Rr42/USB-C-DB/Hardware/README.txt

# Read me for the USB-C display board hardware
This is a mini display board with a USB Type-C connector (carrying USB 2.0) and an onboard micro-controller.

This project is created using KiCAD (v5.1.10).

The goal of this display board is to test and evaluate:
* The USB-C interface for a Micro-controller
    * This design uses ESP-WROOM-02
* (TENTATIVE) Implementation of an onboard battery to power the board when disconnected from power
* (TENTATIVE) Onboard battery charging capability using USB-C

## License
The Software and firmware of this project is licensed under the the MIT license however the hardware is under the [Open Source Hardware](https://www.oshwa.org/definition/) license.
