Rr42/USB-C-DB/(list of files, cad)

Other CAD files:
Mechanical/case/case.blend
