Rr42/USB-C-DB/Hardware/support-sims/PWM/PWM-gen.asc

C1: cap; 47p
C2: cap; 47p
C3: cap; 47p
C4: cap; 47p
C5: cap; 47p
D1: diode; 1N4148
D2: diode; 1N4148
R1: res; 10k
R2: res; 10k
RPOT1: res; 500k
RPOT2: res; 500k
U1: NE555
V1: voltage; 5
Named nets: 0, VCC, PWM_OUT, TGR
1MEG
50% - 500K, 500k
70% - 700k, 300k
10% - 100k, 900k
.tran 1m
