Rr42/USB-C-DB/Hardware/support-sims/Auto-program/auto-program.asc

C1: cap; 0.1µ
C2: cap; 0.1µ
R1: res; 10k
R2: res; 10k
U1: 2N7002
U2: 2N7002
V1: voltage; 3.3
V2: voltage; PWL(0 0 100u 0 101u 3.3 200u 3.3 201u 3.3 300u 3.3 301u 0 400u 0)
V3: voltage; PWL(0 0 100u 0 101u 3.3 200u 3.3 201u 0 300u 0 301u 3.3 400u 3.3)
Named nets: 0, VCC, MCU_EN, MCU_IO0, UART_DTRN, UART_RTSN
.tran 400u
DTR RTS  EN IO0
 0     0      1   1
 1     1      1   1
 1     0      0   1
 0     1      1   0
