Rr42/USB-C-DB/Hardware/support-sims/Current-sns-amp/current-sns-amp.asc

R1: res; 5.1k
R2: res; 10k
R3: res; 1
R4: res; 22.73
R5: res; 5.1k
R6: res; 10k
U4: MAX4352
V1: voltage; PWL(0 0 1m 5)
V2: voltage; 5
V3: voltage; PWL(0 0 1m 220u)
Named nets: 0, +5V, Vinp, Vout, Vinn
Vout = (Vinp-Vinn) (R2/R1)
.tran 0 1.1m
PULSE(0 5 12.5u 100n 100n 12.5u 25u 100)
PULSE(0 5 250u 100n 100n 250u 500u 100)
PWL(0 0 9m 5)
120mA load
