Rr42/USB-C-DB/Hardware/support-sims/Switcher-ripple/switcher-ripple.asc

C1: cap; 0.1µ
C2: cap; 1µ
I1: current; PULSE(0 220m 12.5u 150n 100n 12.5u 25u 100)
L1: ind; 3µ; Ipk=1 Rser=88m Rpar=750 Cpar=500f
L2: ind; 3µ; Ipk=1 Rser=88m Rpar=750 Cpar=500f
M1: nmos; BSZ0904NSI
M2: nmos; BSZ0904NSI
R1: res; 22.73
R2: res; 15
R3: res; 22.73
V1: voltage; PULSE(0 5 12.5u 100n 100n 12.5u 25u 100)
V2: voltage; 5
V3: voltage; PULSE(0 5 12.5u 100n 100n 12.5u 25u 100)
Named nets: 0, Vload, Vsrc, Vpwm
.tran 1m
3.3V
5V
