Rr42/USB-C-DB/Hardware/USB-C-DB/USB-C-DB.kicad_pcb

## KiCad design Hardware/USB-C-DB/USB-C-DB.kicad_pcb (2023-08-28)

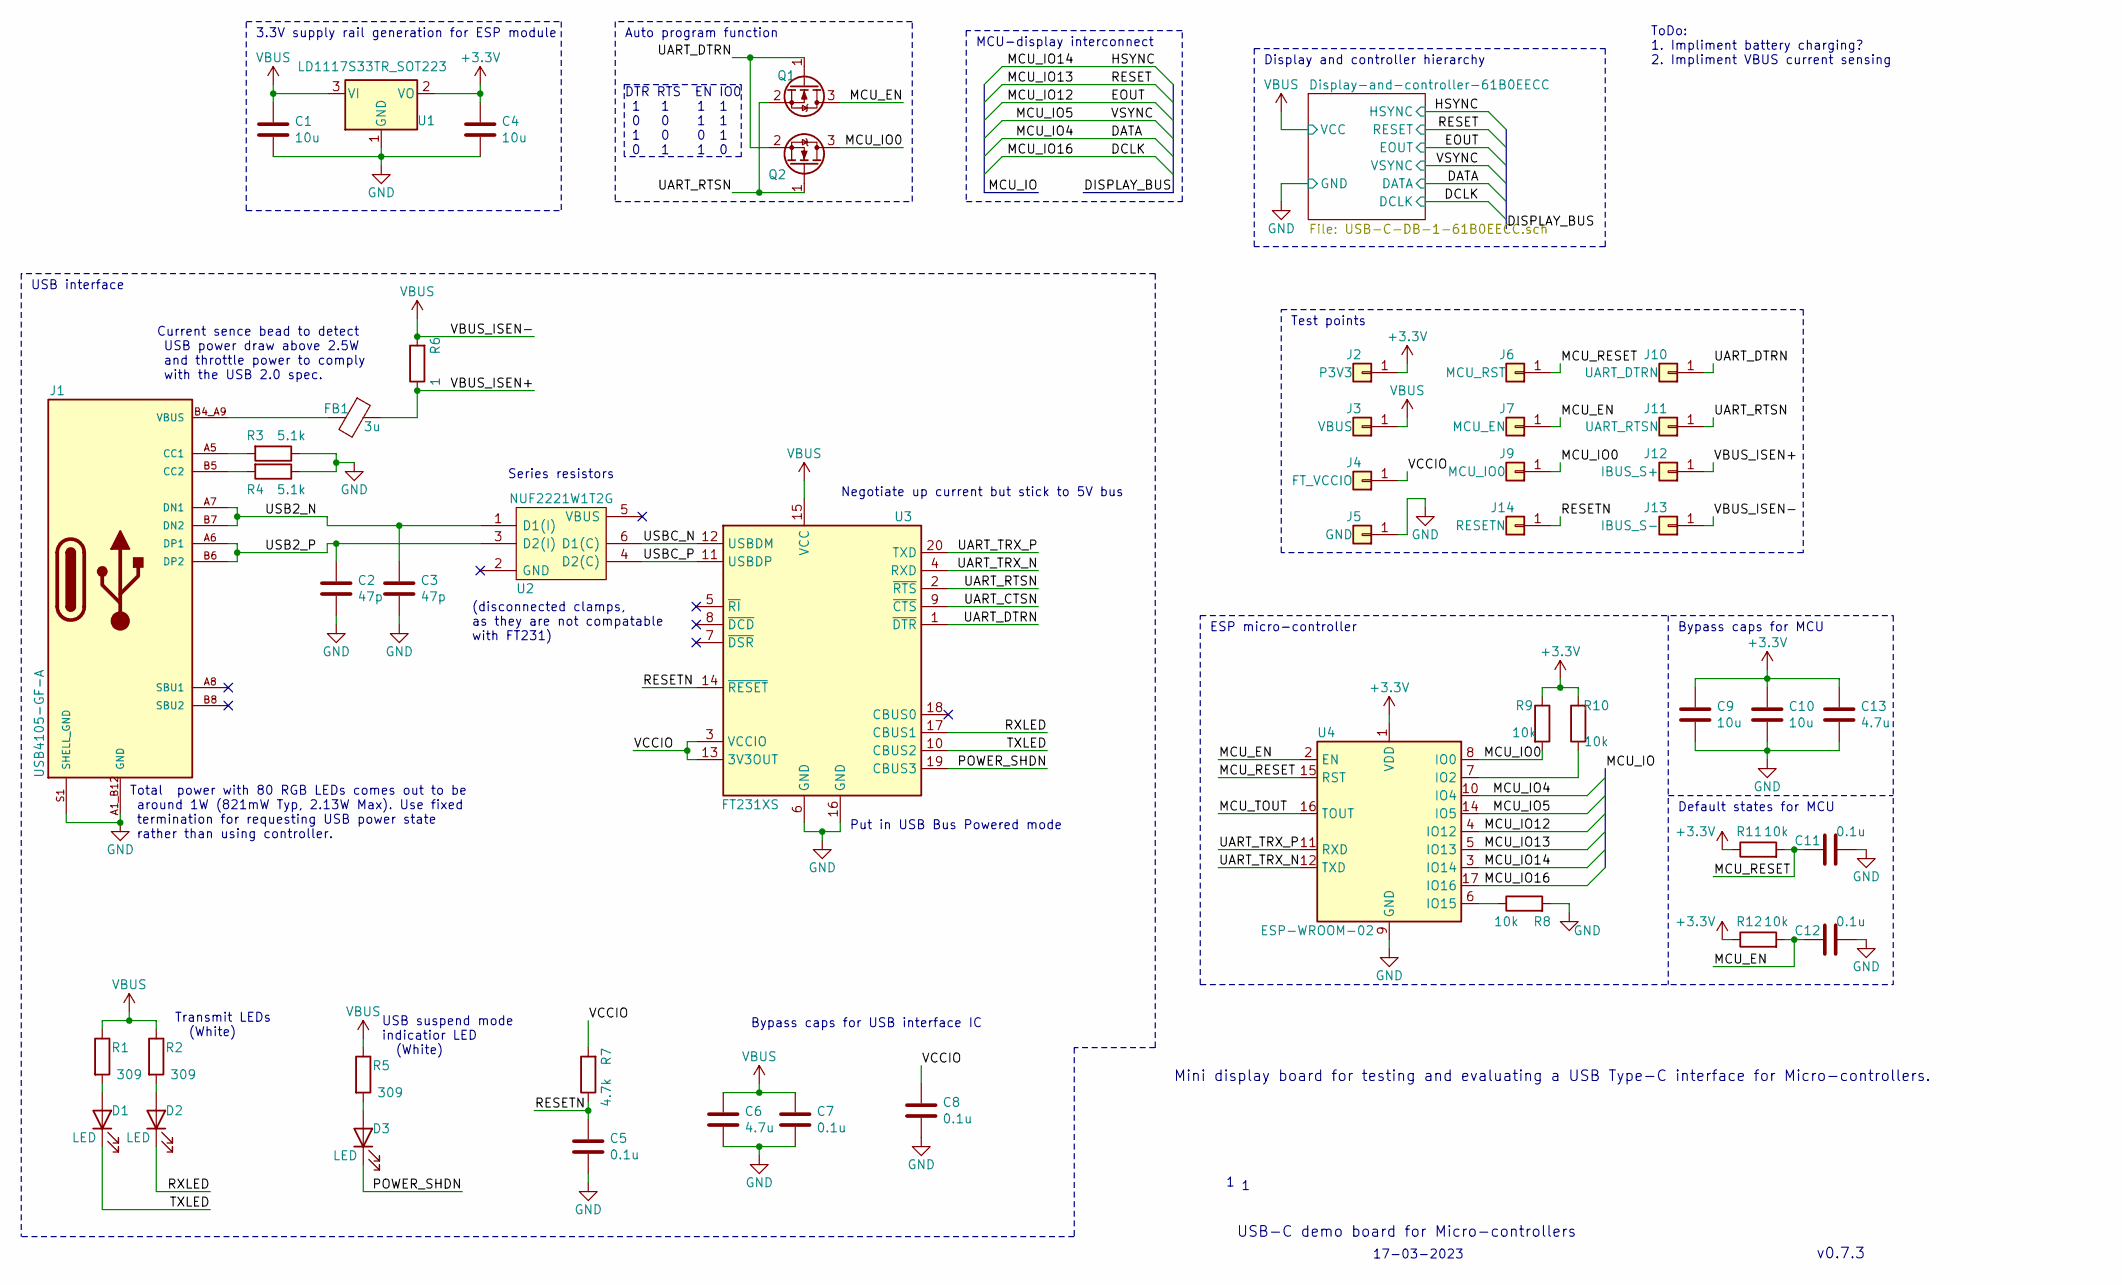
[picture p14: schematic USB-C-DB.sch]

Parts:
C1, C4, C9, C10: 10u; C_0805_2012Metric_Pad1.18x1.45mm_HandSolder; MPN CL21A106KOQNNNE
C2, C3: 47p; C_0402_1005Metric_Pad0.74x0.62mm_HandSolder; MPN C0402C470J5GAC
C5, C7, C8, C11, C12: 0.1u; C_0805_2012Metric_Pad1.18x1.45mm_HandSolder; MPN C0805C104M5RAC
C6, C13: 4.7u; C_0805_2012Metric_Pad1.18x1.45mm_HandSolder; MPN CL21A475KAQNNNF
D1, D2, D3: LED; LED_Cree-PLCC4_3.2x2.8mm_CCW; MPN CLA1A-WKB-CWbYa153
FB1: 3u; R_0603_1608Metric_Pad0.98x0.95mm_HandSolder; MPN KPZ1608SHR601ATD25
J1: USB4105-GF-A; GCT_USB4105-GF-A; PARTREV A3
J2: P3V3; TestPoint_Pad_D1.0mm
J3: VBUS; TestPoint_Pad_D1.0mm
J4: FT_VCCIO; TestPoint_Pad_D1.0mm
J5: GND; TestPoint_Pad_D1.0mm
J6: MCU_RST; TestPoint_Pad_D1.0mm
J7: MCU_EN; TestPoint_Pad_D1.0mm
J9: MCU_IO0; TestPoint_Pad_D1.0mm
J10: UART_DTRN; TestPoint_Pad_D1.0mm
J11: UART_RTSN; TestPoint_Pad_D1.0mm
J12: IBUS_S+; TestPoint_Pad_D1.0mm
J13: IBUS_S-; TestPoint_Pad_D1.0mm
J14: RESETN; TestPoint_Pad_D1.0mm
Q1, Q2: XP262N7002TR-G; SOT-23; MPN XP262N7002TR-G
R1, R2, R5: 309; R_0603_1608Metric_Pad0.98x0.95mm_HandSolder; MPN RC0603FR-07309RL
R3, R4: 5.1k; R_0805_2012Metric_Pad1.20x1.40mm_HandSolder; MPN TR0805KR-075K1L
R6: 1; R_0603_1608Metric_Pad0.98x0.95mm_HandSolder; MPN RT0603DRE071RL
R7: 4.7k; R_0805_2012Metric_Pad1.20x1.40mm_HandSolder; MPN RC0805FR-074K7P
R8, R9, R10, R11, R12: 10k; R_0603_1608Metric_Pad0.98x0.95mm_HandSolder; MPN CRG0603F10K/10
U1: LD1117S33TR_SOT223; SOT-223-3_TabPin2; MPN LD1117S33CTR
U2: NUF2221W1T2G; SOT65P210X110-6N; Mouser Part Number 863-NUF2221W1T2G
U3: FT231XS; SSOP-20_3.9x8.7mm_P0.635mm; MPN FT231XS-R; Mouser Part Number 895-FT231XS-R
U4: ESP-WROOM-02; MPN ESP-WROOM-02D-N2

Connections:
+3V3: C4.1, C9.1, C10.1, C13.1, J2.1, R9.1, R10.2, R11.1, R12.1, U1.2 (VO), U4.1 (VDD)
/DATA: U4.10 (IO4); also elsewhere on the board
/DCLK: U4.17 (IO16); also elsewhere on the board
/EOUT: U4.4 (IO12); also elsewhere on the board
/HSYNC: U4.3 (IO14); also elsewhere on the board
/MCU_EN: C12.1, J7.1, Q1.3 (D), R12.2, U4.2 (EN)
/MCU_IO0: J9.1, Q2.3 (D), R9.2, U4.8 (IO0)
/MCU_IO5: U4.14 (IO5); also elsewhere on the board
/MCU_IO13: U4.5 (IO13); also elsewhere on the board
/MCU_RESET: C11.1, J6.1, R11.2, U4.15 (RST)
/MCU_TOUT: U4.16 (TOUT)
/POWER_SHDN: D3.4 (K), U3.19 (CBUS3)
/RESETN: C5.1, J14.1, R7.1, U3.14 (~RESET)
/RXLED: D2.4 (K), U3.17 (CBUS1)
/TXLED: D1.4 (K), U3.10 (CBUS2)
/UART_CTSN: U3.9 (~CTS)
/UART_DTRN: J10.1, Q1.1 (G), Q2.2 (S), U3.1 (~DTR)
/UART_RTSN: J11.1, Q1.2 (S), Q2.1 (G), U3.2 (~RTS)
/UART_TRX_N: U3.4 (RXD), U4.12 (TXD)
/UART_TRX_P: U3.20 (TXD), U4.11 (RXD)
/USB2_N: C3.1, J1.A7 (DN1), J1.B7 (DN2), U2.1 (D1(I))
/USB2_P: C2.1, J1.A6 (DP1), J1.B6 (DP2), U2.3 (D2(I))
/USBC_N: U2.6 (D1(C)), U3.12 (USBDM)
/USBC_P: U2.4 (D2(C)), U3.11 (USBDP)
/VBUS_ISEN+: FB1.1, J12.1, R6.1
/VCCIO: C8.1, J4.1, R7.2, U3.3 (VCCIO), U3.13 (3V3OUT)
GND: C1.2, C2.2, C3.2, C4.2, C5.2, C6.2, C7.2, C8.2, C9.2, C10.2, C11.2, C12.2, C13.2, J1.A1_B12 (GND), J1.B1_A12 (GND), J1.S1 (SHELL_GND), J1.S2 (SHELL_GND), J1.S3 (SHELL_GND), J1.S4 (SHELL_GND), J5.1, R3.1, R4.1, R8.2, U1.1 (GND), U3.6 (GND), U3.16 (GND), U4.9 (GND), U4.13 (GND), U4.18 (GND), U4.19 (GND); also elsewhere on the board
unnamed: D1.2 (A), R1.2
unnamed: D2.2 (A), R2.2
unnamed: D3.2 (A), R5.2
unnamed: J1.A5 (CC1), R3.2
unnamed: J1.B5 (CC2), R4.2
unnamed: R8.1, U4.6 (IO15)
unnamed: R10.1, U4.7 (IO2)

Notes on the sheet:
USB-C demo board for Micro-controllers
v0.7.3
17-03-2023
Mini display board for testing and evaluating a USB Type-C interface for Micro-controllers.
Total power with 80 RGB LEDs comes out to be around 1W (821mW Typ, 2.13W Max). Use fixed termination for requesting USB power state rather than using controller.
Current sence bead to detect USB power draw above 2.5W and throttle power to comply with the USB 2.0 spec.
Display and controller hierarchy
Series resistors
Bypass caps for USB interface IC
USB interface
Auto program function
DTR RTS EN IO0 1 1 1 1 0 0 1 1 1 0 0 1 0 1 1 0
MCU-display interconnect
3.3V supply rail generation for ESP module
Test points
Default states for MCU
ESP micro-controller
Bypass caps for MCU
ToDo: 1. Impliment battery charging? 2. Impliment VBUS current sensing
Negotiate up current but stick to 5V bus
Put in USB Bus Powered mode
Transmit LEDs (White)
USB suspend mode indicatior LED (White)
(disconnected clamps, as they are not compatable with FT231)

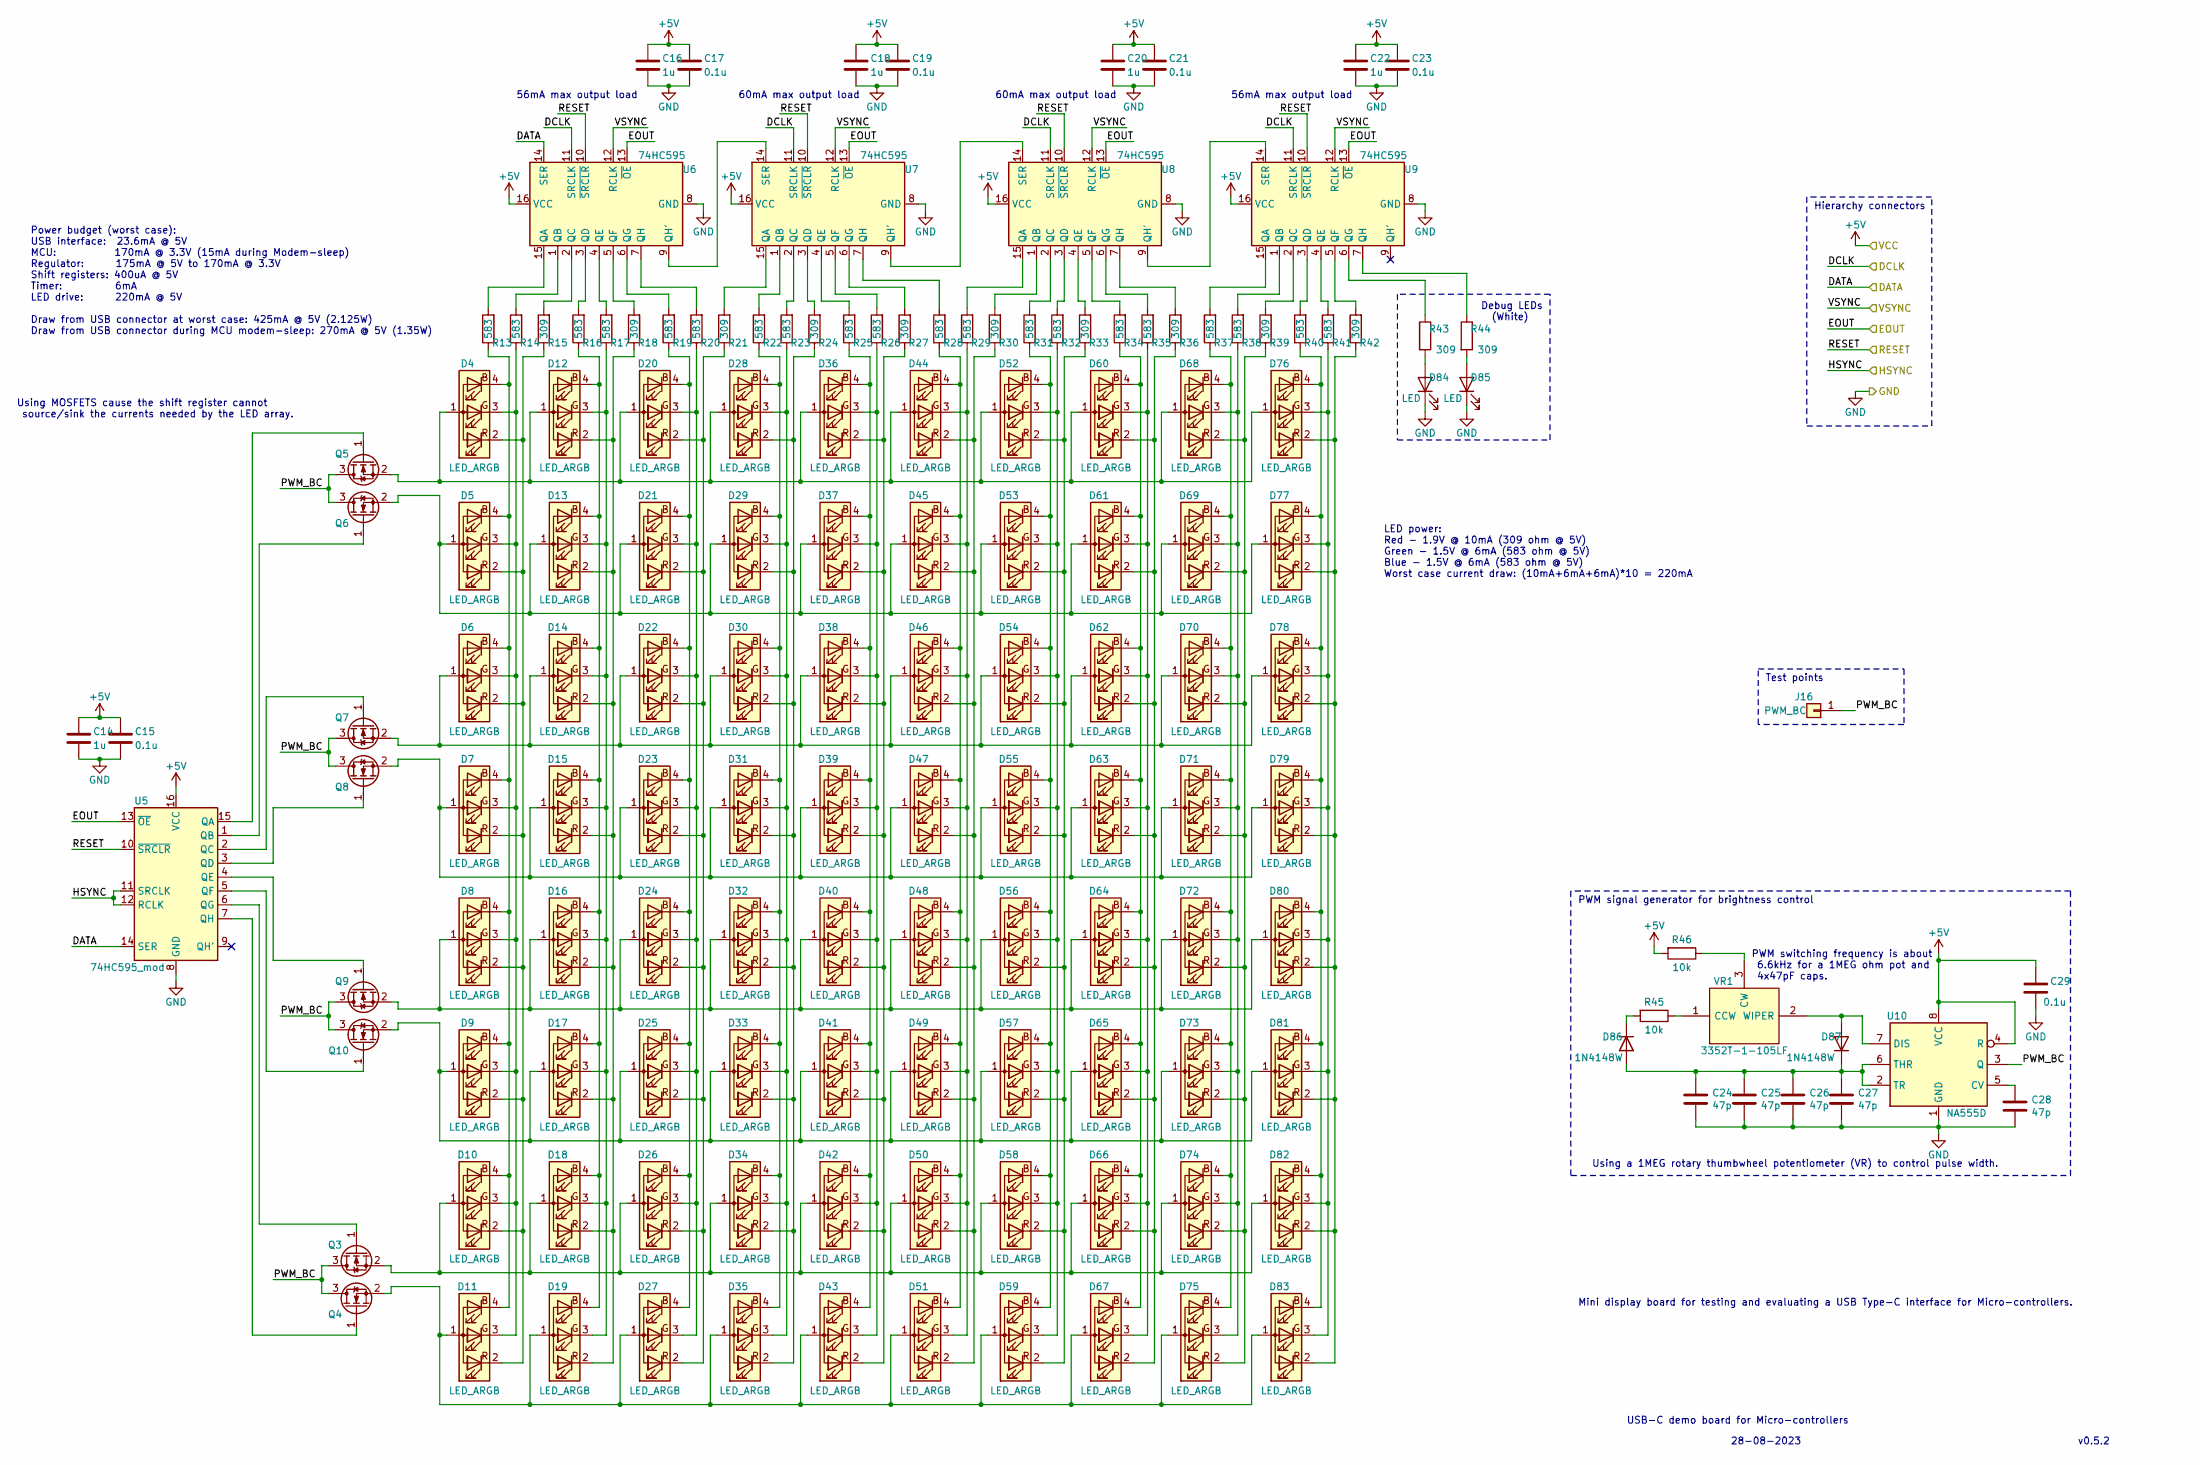
[picture p15: schematic USB-C-DB-1-61B0EECC.sch]

Parts:
C14, C16, C18, C20, C22: 1u; C_0805_2012Metric_Pad1.18x1.45mm_HandSolder; MPN CL21B105KBFNNNG
C15, C17, C19, C21, C23, C29: 0.1u; C_0805_2012Metric_Pad1.18x1.45mm_HandSolder; MPN C0805C104M5RAC
C24, C25, C26, C27, C28: 47p; C_0402_1005Metric_Pad0.74x0.62mm_HandSolder; MPN C0402C470J5GAC
D4, D5, D6, D7, D8, D9, D10, D11, D12, D13, D14, D15, D16, D17, D18, D19, D20, D21, D22, D23, D24, D25, D26, D27, D28, D29, D30, D31, D32, D33, D34, D35, D36, D37, D38, D39, D40, D41, D42, D43, D44, D45, D46, D47, D48, D49, D50, D51, D52, D53, D54, D55, D56, D57, D58, D59, D60, D61, D62, D63, D64, D65, D66, D67, D68, D69, D70, D71, D72, D73, D74, D75, D76, D77, D78, D79, D80, D81, D82, D83: LED_ARGB; LED_Cree-PLCC4_3.2x2.8mm_CCW; MPN CLV1L-FKB-CJ1N1E1BB7B3B3
D84, D85: LED; LED_Cree-PLCC4_3.2x2.8mm_CCW; MPN CLA1A-WKB-CWbYa153
D86, D87: 1N4148W; D_SOD-123; MPN 1N4148W_R1_00001
J16: PWM_BC; TestPoint_Pad_D1.0mm
Q3, Q4, Q5, Q6, Q7, Q8, Q9, Q10: XP262N7002TR-G; SOT-23; MPN XP262N7002TR-G
R13, R14, R16, R17, R19, R20, R22, R23, R25, R26, R28, R29, R31, R32, R34, R35, R37, R38, R40, R41: 583; R_0603_1608Metric_Pad0.98x0.95mm_HandSolder; MPN RT0603DRE07583RL
R15, R18, R21, R24, R27, R30, R33, R36, R39, R42, R43, R44: 309; R_0603_1608Metric_Pad0.98x0.95mm_HandSolder; MPN RC0603FR-07309RL
R45, R46: 10k; R_0603_1608Metric_Pad0.98x0.95mm_HandSolder; MPN CRG0603F10K/10
U5: 74HC595_mod; TSSOP-16_4.4x5mm_P0.65mm; MPN MC74HC595ADTG
U6, U7, U8, U9: 74HC595; TSSOP-16_4.4x5mm_P0.65mm; MPN MC74HC595ADTG
U10: NA555D; SOIC-8_3.9x4.9mm_P1.27mm; MPN NA555DR
VR1: 3352T-1-105LF; 3352T1103LF; Mouser Part Number 652-3352T-1-105LF

Connections:
/DATA: U5.14 (SER), U6.14 (SER); also elsewhere on the board
/DCLK: U6.11 (SRCLK), U7.11 (SRCLK), U8.11 (SRCLK), U9.11 (SRCLK); also elsewhere on the board
/Display-and-controller-61B0EECC/PWM_BC: J16.1, Q3.3 (D), Q4.3 (D), Q5.3 (D), Q6.3 (D), Q7.3 (D), Q8.3 (D), Q9.3 (D), Q10.3 (D), U10.3 (Q)
/EOUT: U5.13 (~OE), U6.13 (~OE), U7.13 (~OE), U8.13 (~OE), U9.13 (~OE); also elsewhere on the board
/HSYNC: U5.11 (SRCLK), U5.12 (RCLK); also elsewhere on the board
/MCU_IO5: U6.12 (RCLK), U7.12 (RCLK), U8.12 (RCLK), U9.12 (RCLK); also elsewhere on the board
/MCU_IO13: U5.10 (~SRCLR), U6.10 (~SRCLR), U7.10 (~SRCLR), U8.10 (~SRCLR), U9.10 (~SRCLR); also elsewhere on the board
GND: C14.2, C15.2, C16.2, C17.2, C18.2, C19.2, C20.2, C21.2, C22.2, C23.2, C24.2, C25.2, C26.2, C27.2, C28.2, C29.2, D84.4 (K), D85.4 (K), U5.8 (GND), U6.8 (GND), U7.8 (GND), U8.8 (GND), U9.8 (GND), U10.1 (GND); also elsewhere on the board
unnamed: C24.1, C25.1, C26.1, C27.1, D86.2 (A), D87.1 (K), U10.2 (TR), U10.6 (THR)
unnamed: C28.1, U10.5 (CV)
unnamed: D10.1 (A), D18.1 (A), D26.1 (A), D34.1 (A), D42.1 (A), D50.1 (A), D58.1 (A), D66.1 (A), D74.1 (A), D82.1 (A), Q3.2 (S)
unnamed: D4.2 (RK), D5.2 (RK), D6.2 (RK), D7.2 (RK), D8.2 (RK), D9.2 (RK), D10.2 (RK), D11.2 (RK), R15.1
unnamed: D4.3 (GK), D5.3 (GK), D6.3 (GK), D7.3 (GK), D8.3 (GK), D9.3 (GK), D10.3 (GK), D11.3 (GK), R14.1
unnamed: D4.4 (BK), D5.4 (BK), D6.4 (BK), D7.4 (BK), D8.4 (BK), D9.4 (BK), D10.4 (BK), D11.4 (BK), R13.1
unnamed: D11.1 (A), D19.1 (A), D27.1 (A), D35.1 (A), D43.1 (A), D51.1 (A), D59.1 (A), D67.1 (A), D75.1 (A), D83.1 (A), Q4.2 (S)
unnamed: D4.1 (A), D12.1 (A), D20.1 (A), D28.1 (A), D36.1 (A), D44.1 (A), D52.1 (A), D60.1 (A), D68.1 (A), D76.1 (A), Q5.2 (S)
unnamed: D12.2 (RK), D13.2 (RK), D14.2 (RK), D15.2 (RK), D16.2 (RK), D17.2 (RK), D18.2 (RK), D19.2 (RK), R18.1
unnamed: D12.3 (GK), D13.3 (GK), D14.3 (GK), D15.3 (GK), D16.3 (GK), D17.3 (GK), D18.3 (GK), D19.3 (GK), R17.1
unnamed: D12.4 (BK), D13.4 (BK), D14.4 (BK), D15.4 (BK), D16.4 (BK), D17.4 (BK), D18.4 (BK), D19.4 (BK), R16.1
unnamed: D5.1 (A), D13.1 (A), D21.1 (A), D29.1 (A), D37.1 (A), D45.1 (A), D53.1 (A), D61.1 (A), D69.1 (A), D77.1 (A), Q6.2 (S)
unnamed: D6.1 (A), D14.1 (A), D22.1 (A), D30.1 (A), D38.1 (A), D46.1 (A), D54.1 (A), D62.1 (A), D70.1 (A), D78.1 (A), Q7.2 (S)
unnamed: D7.1 (A), D15.1 (A), D23.1 (A), D31.1 (A), D39.1 (A), D47.1 (A), D55.1 (A), D63.1 (A), D71.1 (A), D79.1 (A), Q8.2 (S)
unnamed: D8.1 (A), D16.1 (A), D24.1 (A), D32.1 (A), D40.1 (A), D48.1 (A), D56.1 (A), D64.1 (A), D72.1 (A), D80.1 (A), Q9.2 (S)
unnamed: D9.1 (A), D17.1 (A), D25.1 (A), D33.1 (A), D41.1 (A), D49.1 (A), D57.1 (A), D65.1 (A), D73.1 (A), D81.1 (A), Q10.2 (S)
unnamed: D20.2 (RK), D21.2 (RK), D22.2 (RK), D23.2 (RK), D24.2 (RK), D25.2 (RK), D26.2 (RK), D27.2 (RK), R21.1
unnamed: D20.3 (GK), D21.3 (GK), D22.3 (GK), D23.3 (GK), D24.3 (GK), D25.3 (GK), D26.3 (GK), D27.3 (GK), R20.1
unnamed: D20.4 (BK), D21.4 (BK), D22.4 (BK), D23.4 (BK), D24.4 (BK), D25.4 (BK), D26.4 (BK), D27.4 (BK), R19.1
unnamed: D28.2 (RK), D29.2 (RK), D30.2 (RK), D31.2 (RK), D32.2 (RK), D33.2 (RK), D34.2 (RK), D35.2 (RK), R24.1
unnamed: D28.3 (GK), D29.3 (GK), D30.3 (GK), D31.3 (GK), D32.3 (GK), D33.3 (GK), D34.3 (GK), D35.3 (GK), R23.1
unnamed: D28.4 (BK), D29.4 (BK), D30.4 (BK), D31.4 (BK), D32.4 (BK), D33.4 (BK), D34.4 (BK), D35.4 (BK), R22.1
unnamed: D36.2 (RK), D37.2 (RK), D38.2 (RK), D39.2 (RK), D40.2 (RK), D41.2 (RK), D42.2 (RK), D43.2 (RK), R27.1
unnamed: D36.3 (GK), D37.3 (GK), D38.3 (GK), D39.3 (GK), D40.3 (GK), D41.3 (GK), D42.3 (GK), D43.3 (GK), R26.1
unnamed: D36.4 (BK), D37.4 (BK), D38.4 (BK), D39.4 (BK), D40.4 (BK), D41.4 (BK), D42.4 (BK), D43.4 (BK), R25.1
unnamed: D44.2 (RK), D45.2 (RK), D46.2 (RK), D47.2 (RK), D48.2 (RK), D49.2 (RK), D50.2 (RK), D51.2 (RK), R30.1
unnamed: D44.3 (GK), D45.3 (GK), D46.3 (GK), D47.3 (GK), D48.3 (GK), D49.3 (GK), D50.3 (GK), D51.3 (GK), R29.1
unnamed: D44.4 (BK), D45.4 (BK), D46.4 (BK), D47.4 (BK), D48.4 (BK), D49.4 (BK), D50.4 (BK), D51.4 (BK), R28.1
unnamed: D52.2 (RK), D53.2 (RK), D54.2 (RK), D55.2 (RK), D56.2 (RK), D57.2 (RK), D58.2 (RK), D59.2 (RK), R33.1
unnamed: D52.3 (GK), D53.3 (GK), D54.3 (GK), D55.3 (GK), D56.3 (GK), D57.3 (GK), D58.3 (GK), D59.3 (GK), R32.1
unnamed: D52.4 (BK), D53.4 (BK), D54.4 (BK), D55.4 (BK), D56.4 (BK), D57.4 (BK), D58.4 (BK), D59.4 (BK), R31.1
unnamed: D60.2 (RK), D61.2 (RK), D62.2 (RK), D63.2 (RK), D64.2 (RK), D65.2 (RK), D66.2 (RK), D67.2 (RK), R36.1
unnamed: D60.3 (GK), D61.3 (GK), D62.3 (GK), D63.3 (GK), D64.3 (GK), D65.3 (GK), D66.3 (GK), D67.3 (GK), R35.1
unnamed: D60.4 (BK), D61.4 (BK), D62.4 (BK), D63.4 (BK), D64.4 (BK), D65.4 (BK), D66.4 (BK), D67.4 (BK), R34.1
unnamed: D68.2 (RK), D69.2 (RK), D70.2 (RK), D71.2 (RK), D72.2 (RK), D73.2 (RK), D74.2 (RK), D75.2 (RK), R39.1
unnamed: D68.3 (GK), D69.3 (GK), D70.3 (GK), D71.3 (GK), D72.3 (GK), D73.3 (GK), D74.3 (GK), D75.3 (GK), R38.1
unnamed: D68.4 (BK), D69.4 (BK), D70.4 (BK), D71.4 (BK), D72.4 (BK), D73.4 (BK), D74.4 (BK), D75.4 (BK), R37.1
unnamed: D76.2 (RK), D77.2 (RK), D78.2 (RK), D79.2 (RK), D80.2 (RK), D81.2 (RK), D82.2 (RK), D83.2 (RK), R42.1
unnamed: D76.3 (GK), D77.3 (GK), D78.3 (GK), D79.3 (GK), D80.3 (GK), D81.3 (GK), D82.3 (GK), D83.3 (GK), R41.1
unnamed: D76.4 (BK), D77.4 (BK), D78.4 (BK), D79.4 (BK), D80.4 (BK), D81.4 (BK), D82.4 (BK), D83.4 (BK), R40.1
unnamed: D84.2 (A), R43.2
unnamed: D85.2 (A), R44.2
unnamed: D86.1 (K), R45.2
unnamed: D87.2 (A), U10.7 (DIS), VR1.2 (WIPER)
unnamed: Q3.1 (G), U5.6 (QG)
unnamed: Q4.1 (G), U5.7 (QH)
unnamed: Q5.1 (G), U5.15 (QA)
unnamed: Q6.1 (G), U5.1 (QB)
unnamed: Q7.1 (G), U5.2 (QC)
unnamed: Q8.1 (G), U5.3 (QD)
unnamed: Q9.1 (G), U5.4 (QE)
unnamed: Q10.1 (G), U5.5 (QF)
unnamed: R13.2, U6.15 (QA)
unnamed: R14.2, U6.1 (QB)
unnamed: R15.2, U6.2 (QC)
unnamed: R16.2, U6.3 (QD)
unnamed: R17.2, U6.4 (QE)
unnamed: R18.2, U6.5 (QF)
unnamed: R19.2, U6.6 (QG)
unnamed: R20.2, U6.7 (QH)
unnamed: R21.2, U7.15 (QA)
unnamed: R22.2, U7.1 (QB)
unnamed: R23.2, U7.2 (QC)
unnamed: R24.2, U7.3 (QD)
unnamed: R25.2, U7.4 (QE)
unnamed: R26.2, U7.5 (QF)
unnamed: R27.2, U7.6 (QG)
unnamed: R28.2, U7.7 (QH)
unnamed: R29.2, U8.15 (QA)
unnamed: R30.2, U8.1 (QB)
unnamed: R31.2, U8.2 (QC)
unnamed: R32.2, U8.3 (QD)
unnamed: R33.2, U8.4 (QE)
unnamed: R34.2, U8.5 (QF)
unnamed: R35.2, U8.6 (QG)
unnamed: R36.2, U8.7 (QH)
unnamed: R37.2, U9.15 (QA)
unnamed: R38.2, U9.1 (QB)
unnamed: R39.2, U9.2 (QC)
unnamed: R40.2, U9.3 (QD)
unnamed: R41.2, U9.4 (QE)
unnamed: R42.2, U9.5 (QF)
unnamed: R43.1, U9.6 (QG)
unnamed: R44.1, U9.7 (QH)
unnamed: R45.1, VR1.1 (CCW)
unnamed: R46.1, VR1.3 (CW)
unnamed: U6.9 (QH'), U7.14 (SER)
unnamed: U7.9 (QH'), U8.14 (SER)
unnamed: U8.9 (QH'), U9.14 (SER)

Notes on the sheet:
USB-C demo board for Micro-controllers
28-08-2023
v0.5.2
Debug LEDs (White)
LED power: Red - 1.9V @ 10mA (309 ohm @ 5V) Green - 1.5V @ 6mA (583 ohm @ 5V) Blue - 1.5V @ 6mA (583 ohm @ 5V) Worst case current draw: (10mA+6mA+6mA)*10 = 220mA
Mini display board for testing and evaluating a USB Type-C interface for Micro-controllers.
Hierarchy connectors
Power budget (worst case): USB interface: 23.6mA @ 5V MCU: 170mA @ 3.3V (15mA during Modem-sleep) Regulator: 175mA @ 5V to 170mA @ 3.3V Shift registers: 400uA @ 5V Timer: 6mA LED drive: 220mA @ 5V Draw from USB connector at worst case: 425mA @ 5V (2.125W) Draw from USB connector during MCU modem-sl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
Using MOSFETS cause the shift register cannot source/sink the currents needed by the LED array.
Using a 1MEG rotary thumbwheel potentiometer (VR) to control pulse width.
PWM switching frequency is about 6.6kHz for a 1MEG ohm pot and 4x47pF caps.
PWM signal generator for brightness control
Test points
60mA max output load
56mA max output load

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
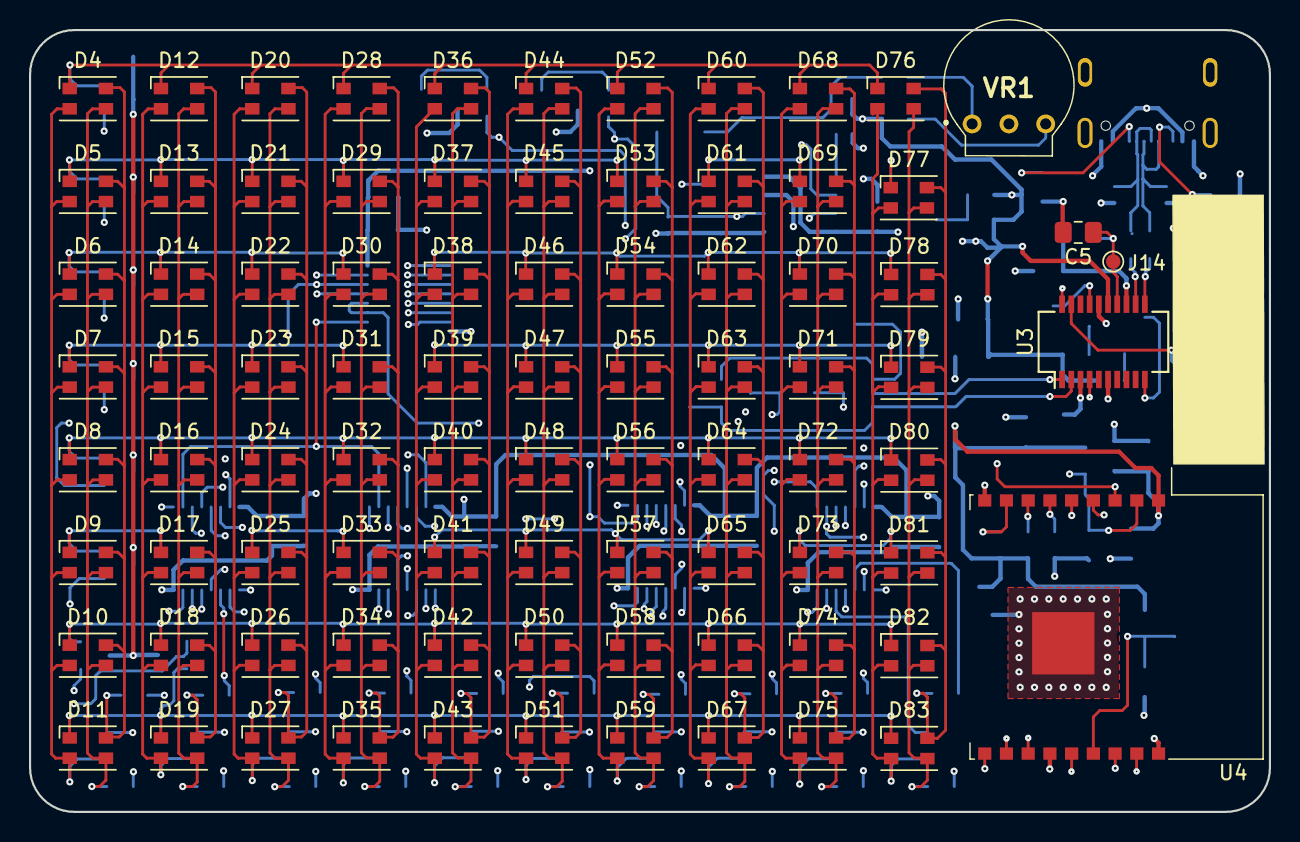
[picture p16: board USB-C-DB.kicad_pcb from above]

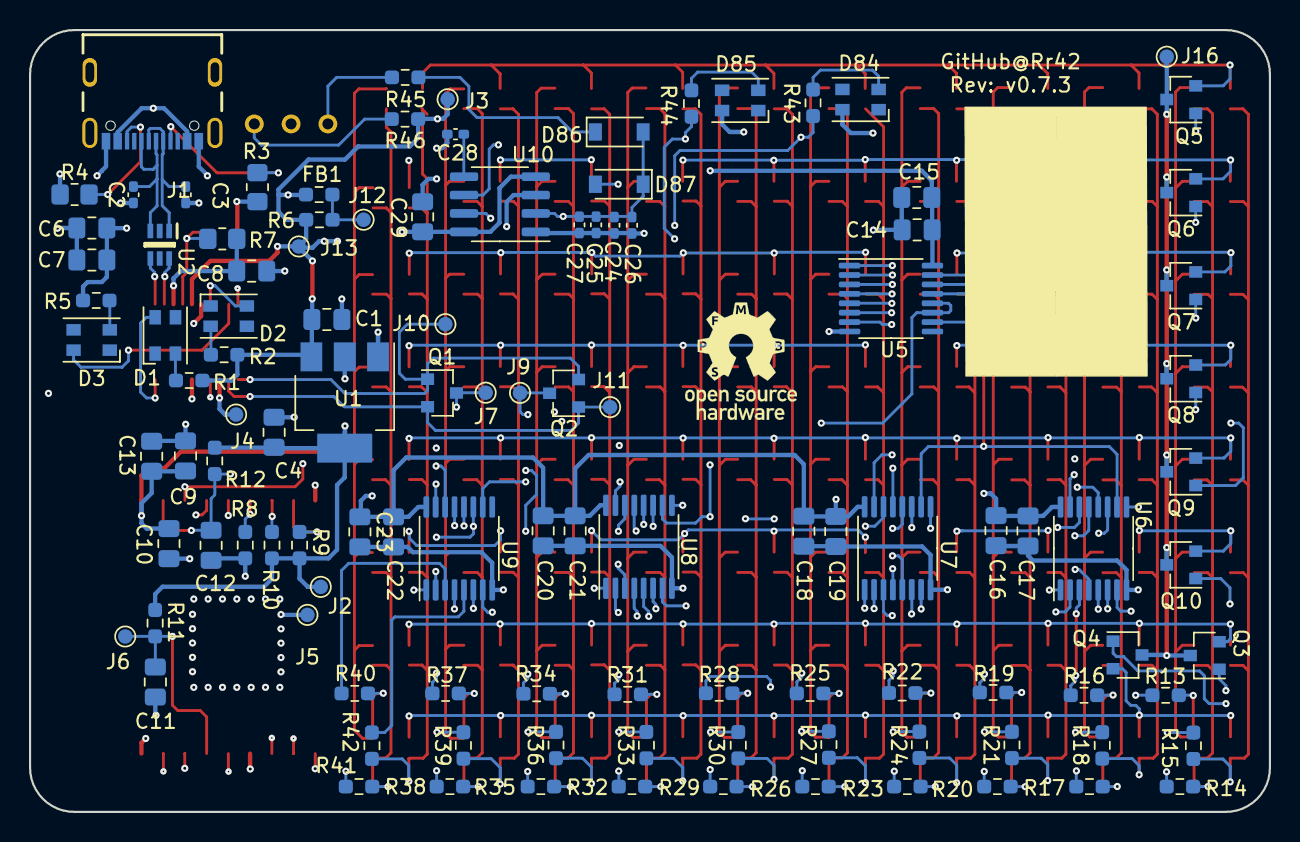
[picture p17: board USB-C-DB.kicad_pcb from below]

Board: 4 copper layers, 85.6 x 54.0 mm, 199 parts (114 on the bottom side), 123 nets.

Other parts of the board:
G1: LOGO; oshw-spfmb
