Rr42/USB-C-DB/(commit log)

2021-08-29 First commit > Adding Readme for repository > Adding Lcense for repository > Adding placeholder KiCAD project
    [USB-C-DB.kicad_pcb, USB-C-DB.sch]
2021-12-17 Updating schematic to v0.2 > Added USB to UART bridge and initial biasing > Added biasing circuitry for MCU > Moved display section to hierarchy > Simplified and consolidated power supply section > A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
    [USB-C-DB-1-61B0EECC.sch, USB-C-DB.sch]
2022-02-12 Wiring up USB interface (schematic v0.3) > Adding ESD circuity for USB interface > Adding remaining bias and configuration circuity for the UBS interface IC
    [USB-C-DB-1-61B0EECC.sch, USB-C-DB.sch]
2022-02-21 Adding PWM based brightness control circuit for display
    [USB-C-DB-1-61B0EECC.sch, USB-C-DB.sch]
2022-02-22 Adding LED array to display subsection
    [USB-C-DB-1-61B0EECC.sch, USB-C-DB.sch]
2022-02-23 Wiring up display subsection
    [USB-C-DB-1-61B0EECC.sch, USB-C-DB.sch]
2022-03-08 Adding auto program functionality
    > Adding OSHW logo to schematics
    > Adding Test points for select signals
    > Updating README with schematic images
    [USB-C-DB-1-61B0EECC.sch, USB-C-DB.sch]
2022-03-08 Minor corrections in README
    Fixing schematic image paths.
2022-03-09 Cleaning up schematic after power budgeting
    [USB-C-DB-1-61B0EECC.sch, USB-C-DB.sch]
2022-03-11 Finalizing schematic for BOM analysis
    * Replacing MOSFET parts with higher current version.
    * Re-adding 555 based brightness control circuit.
    [USB-C-DB-1-61B0EECC.sch, USB-C-DB.sch]
2022-03-16 Updating with alternative parts
    [USB-C-DB-1-61B0EECC.sch, USB-C-DB.sch]
2022-03-17 Adding OSHW logo on PCB
    * Updating BOM with available parts for test run
    [USB-C-DB-1-61B0EECC.sch, USB-C-DB.kicad_pcb, USB-C-DB.sch]
2022-03-21 Adding full layout for design
    [USB-C-DB.kicad_pcb, USB-C-DB.sch]
2022-03-22 Updating layout with version info
    [USB-C-DB.kicad_pcb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]
2022-08-28 Updating schematic to replace FT260 for FT231
    [USB-C-DB-1-61B0EECC.sch, USB-C-DB.kicad_pcb, USB-C-DB.sch]
2022-09-05 Updating layout to replace FT260 for FT231
    [USB-C-DB.kicad_pcb, USB-C-DB.sch]
2022-11-01 Fixing incorrect connection in debug LEDs
    * Updating symbol to fix incorrect GND connection in debug LED
    * Adding image of assembled demo
    [USB-C-DB-1-61B0EECC.sch, USB-C-DB.kicad_pcb, USB-C-DB.sch]
2022-11-01 Adding sample firmware
2022-11-08 Renaming display library and adding default constructor
    * Reordering color frame argument order
    * Correcting bit frame size to 10 from 11
2022-12-09 Adding 3D model for printable case
    [case.blend]
2023-01-18 Updating case design dial and adding readme for software section
    * Updating case design to prevent minor collision with brightness dial
    * Adding a common README for USB-C DB's software and firmware
    * Adding connection and power information to main README
    [case.blend]
2023-02-20 Adding functional custom mode
    * Adding separate custom mode page with Ajax callbacks allowing back communication from HTML client to the display board
    * Adding reference HTML files
2023-02-27 Adding placeholder for frame builder tool
2023-02-28 Moving library definitions and functions to septate file
    * Migrated all class definitions and implementations to DBframe.py
    * Cleaned up main frame-builder.py for managing UI
2023-03-17 Patching activity LED connections and adding FTDI firmware
    * Patching issue in layout where the FTDI activity LED orientations where incorrectly connected.
    * Adding firmware template and instructions to modify the FT231's EEPROM firmware
    [USB-C-DB.kicad_pcb, USB-C-DB.sch]
2023-05-18 Updating schematic SVGs to latest version
2023-08-28 Updating OSHW logo to include mechanicals
    [USB-C-DB-1-61B0EECC.sch, USB-C-DB.kicad_pcb, USB-C-DB.sch]
2024-01-04 Adding implementation for custom frame builder
    * Adding transpose function to DBframe library
    * Adding frame builder UI framework
    * Adding UI based frame builder tool
    * Updating software readme with frame builder instructions
